RishiNandha/TubeAmpPedal/README.md

# TubeAmpPedal
 
Guitar Pedal built to experiement with the harmonics effects produced by a Cathode Tube Triode
