RishiNandha/TubeAmpPedal/Schematic Design/Schematic_Tubeamppedal_2023-07-10.png

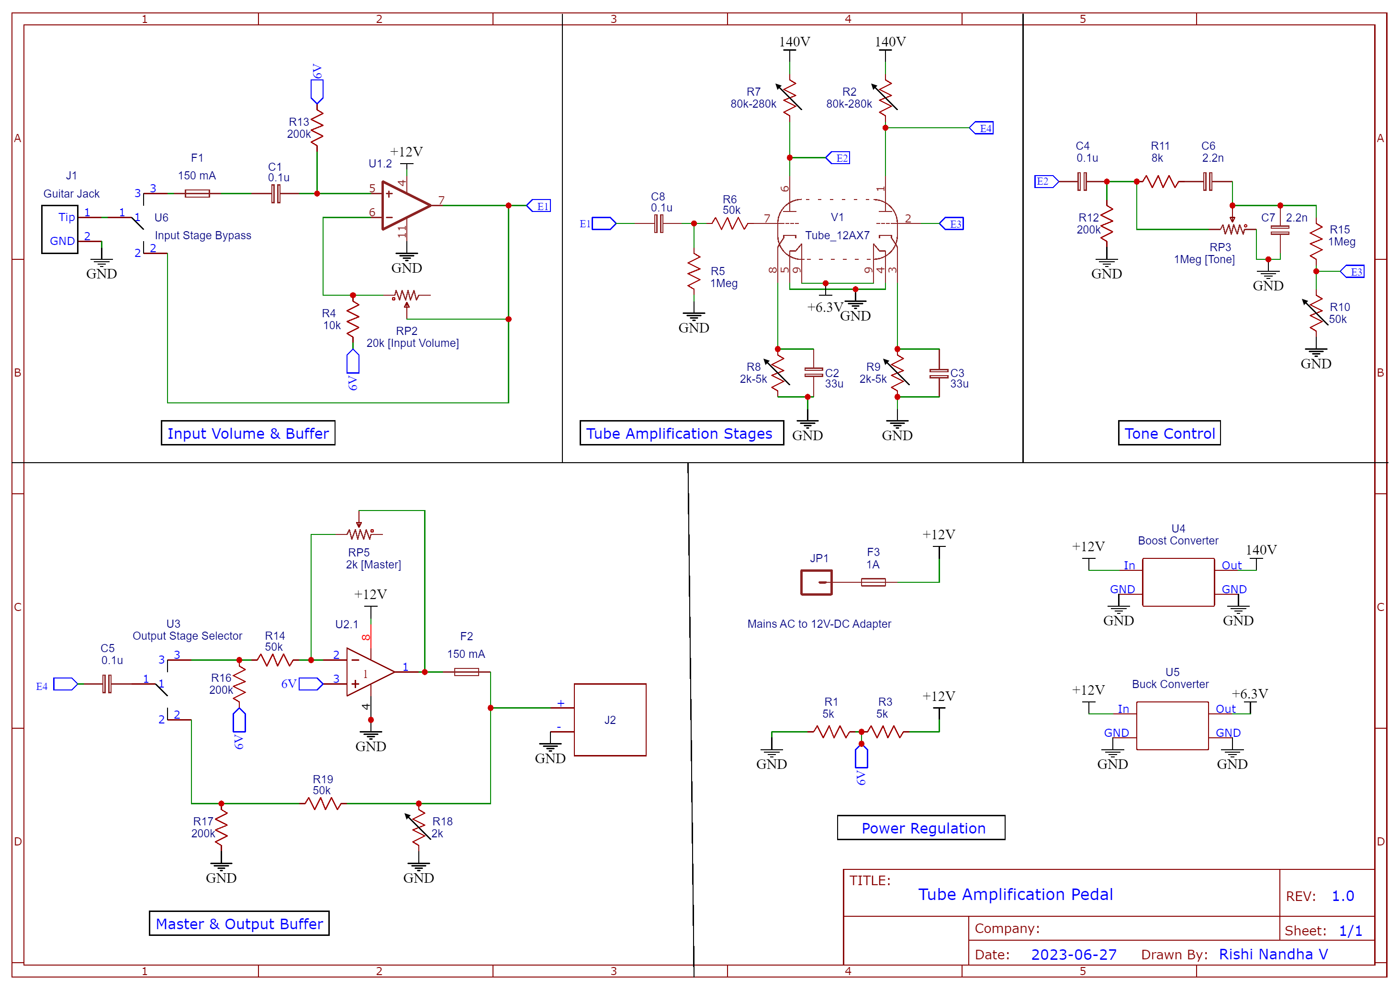
Schematic Design/Schematic_Tubeamppedal_2023-07-10.png
