RishiNandha/TubeAmpPedal/Schematic.pdf

# 6V ⁶V

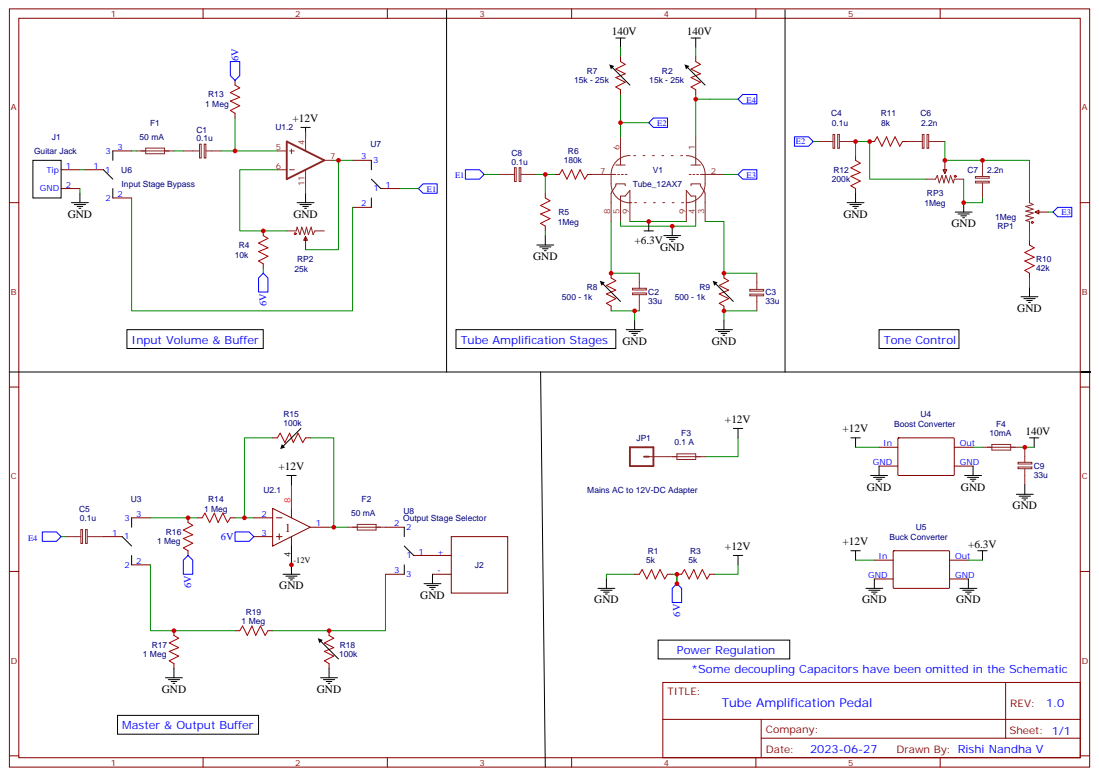
[picture p20: page 1]

Mains AC to 12V-DC Adapter

Power Regulation
*Some decoupling Capacitors have been omitted in the Schematic
TITLE:

Drawn By: Rishi Nandha V
