RishiNandha/TubeAmpPedal/Schematic Design/tonecontrol.asc

C1: cap; 0.1µ
C2: cap; 2.2n
C3: cap; 2.2n
R1: res; 200k
R2: res; 8k
R3: res; {Y}
R4: res; {1Meg-Y}
R5: res; 1Meg
V1: voltage; AC 1
Named nets: 0
.ac oct 1000  1 30k
.step PARAM Y 100k 910k 100k
