RishiNandha/TubeAmpPedal/(list of files, drawings)

Other design files:
Old (12AX7)/Schematic Design/SCH_Tubeamppedal_2023-07-10.json
Schematic Design/SCH_Tubeamppedal_2023-07-10.json
Schematic Design/SCH_Tubeamppedal_2023-08-07.json
